dl1bz/NepControl50W/HF50W-auto-www.60dbm.com.pdf

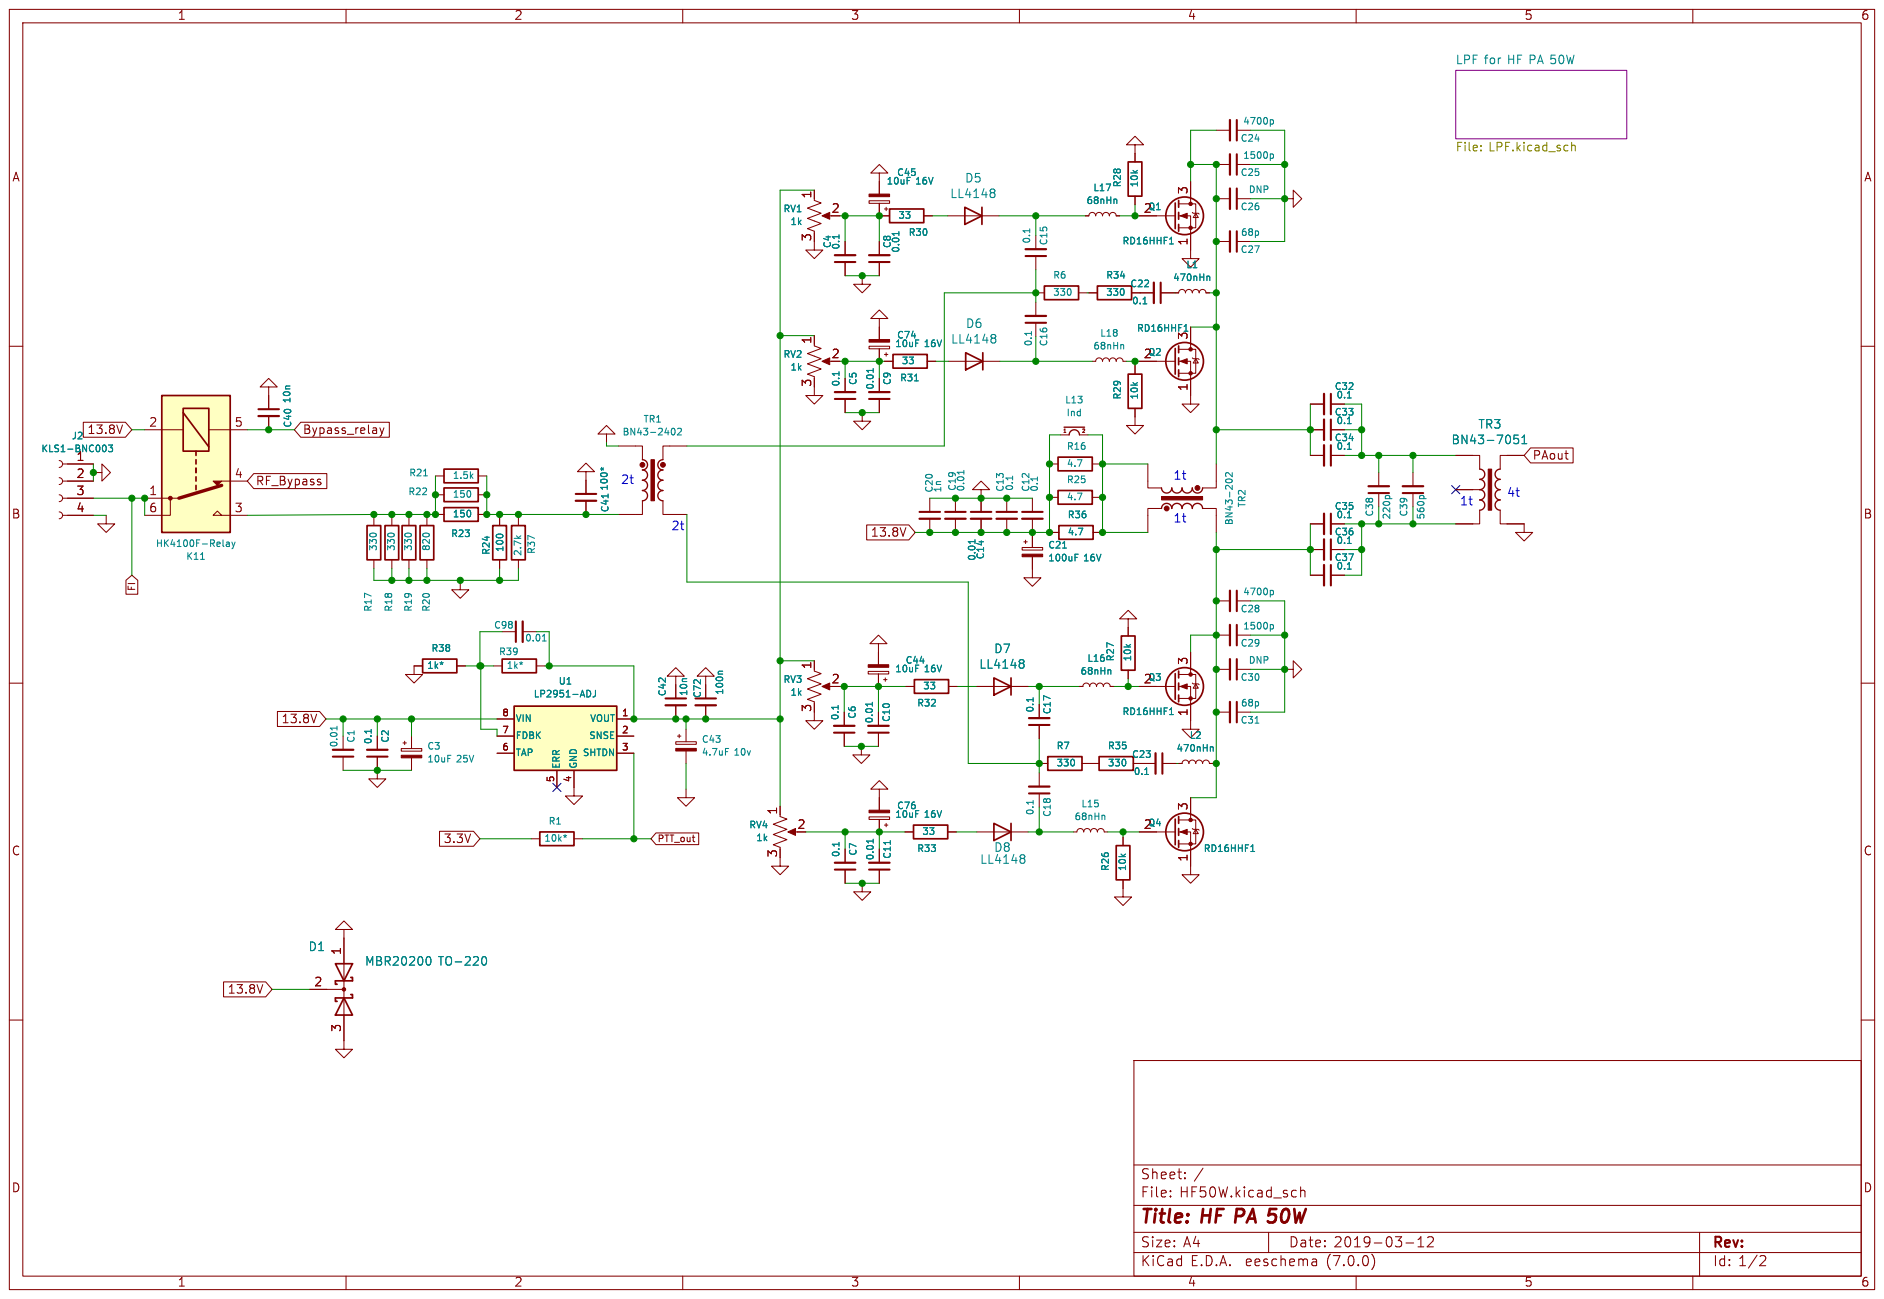
[picture p1: page 1]

File: HF50W.kicad_sch Sheet: /
Id: 1/2 Title: HF PA 50W

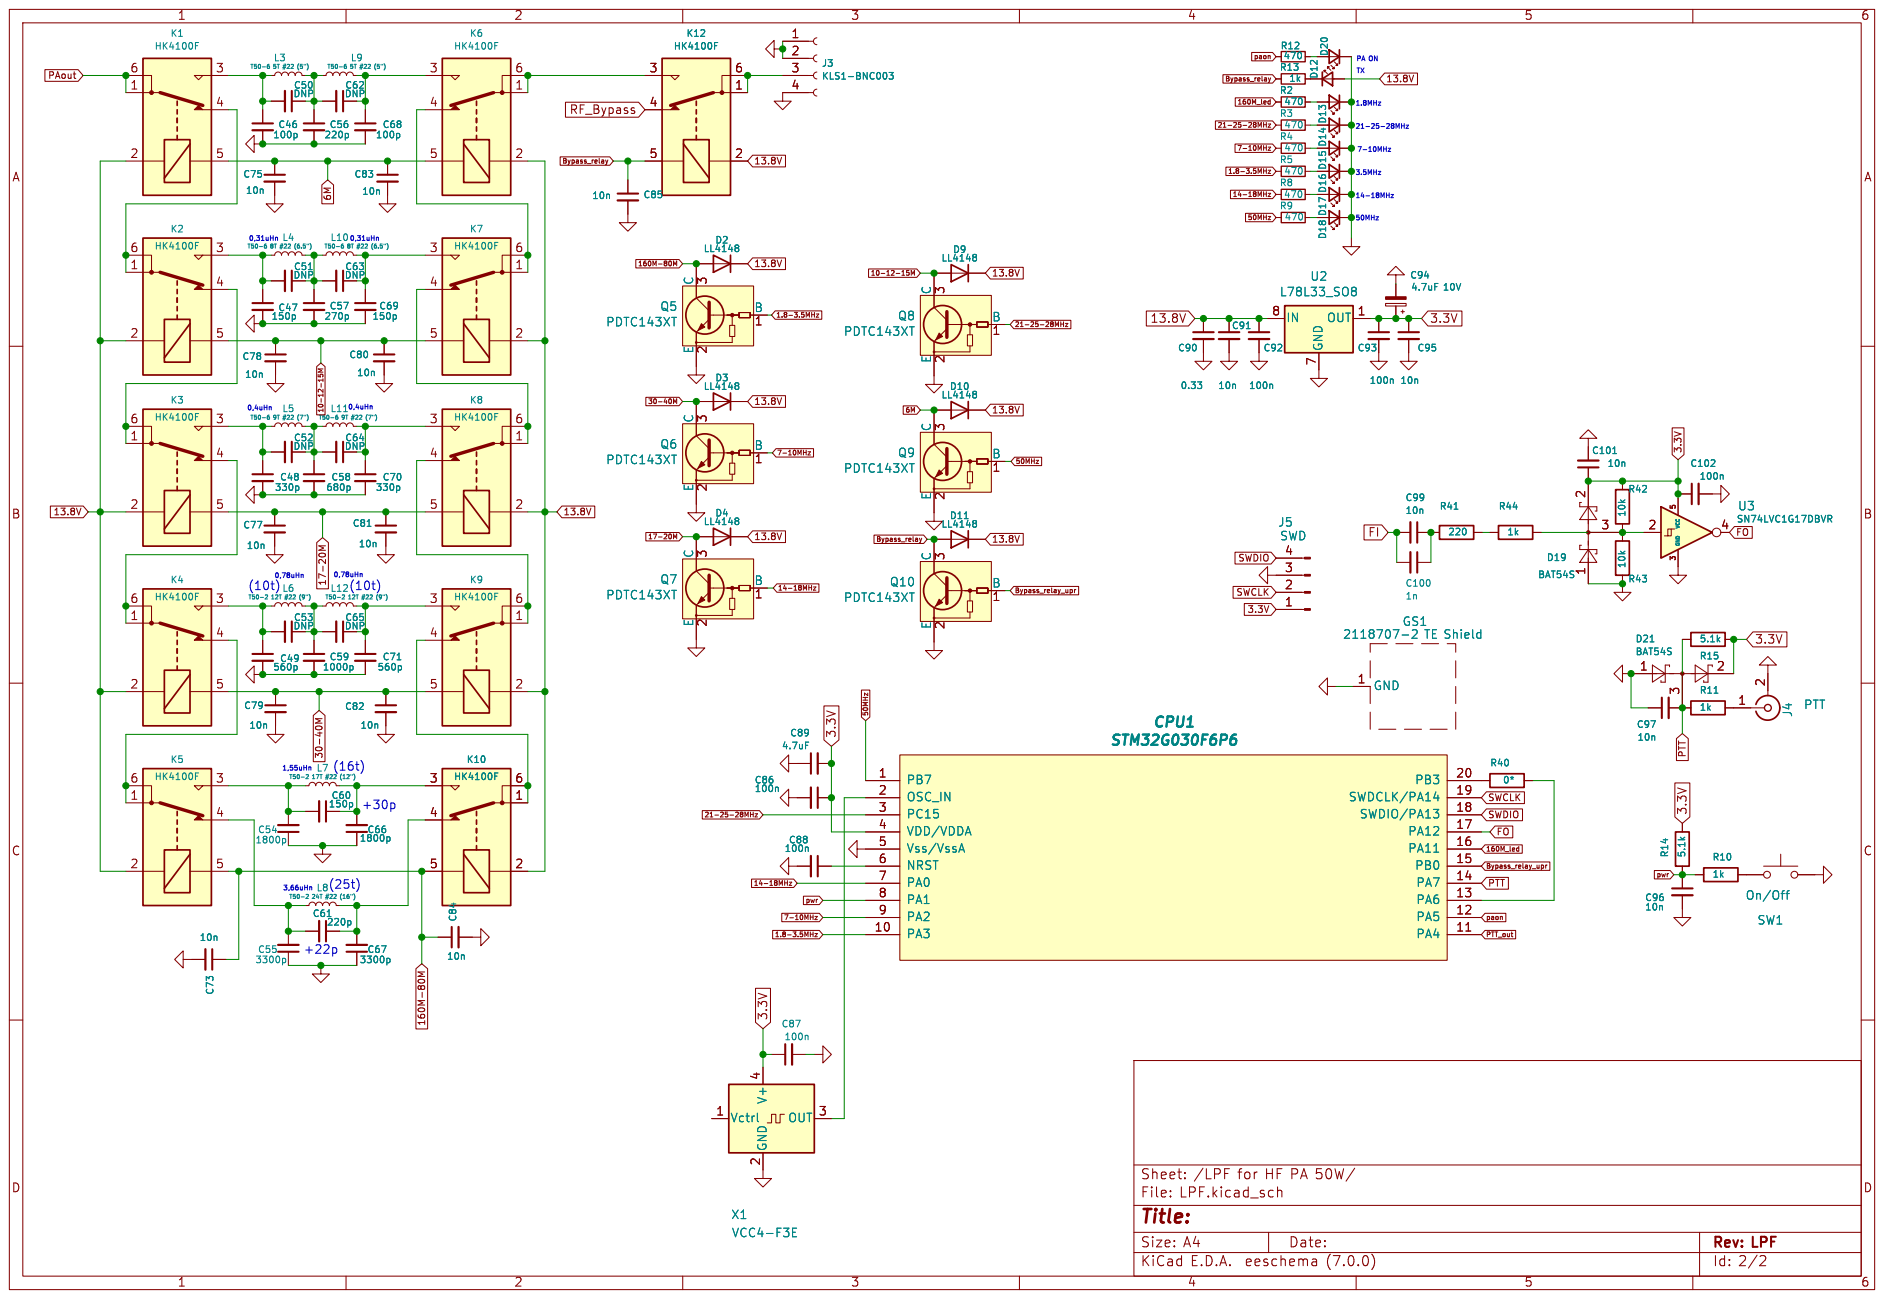
[picture p2: page 2]
