dl1bz/NepControl50W/Neptune_50W_ESP32control.pdf

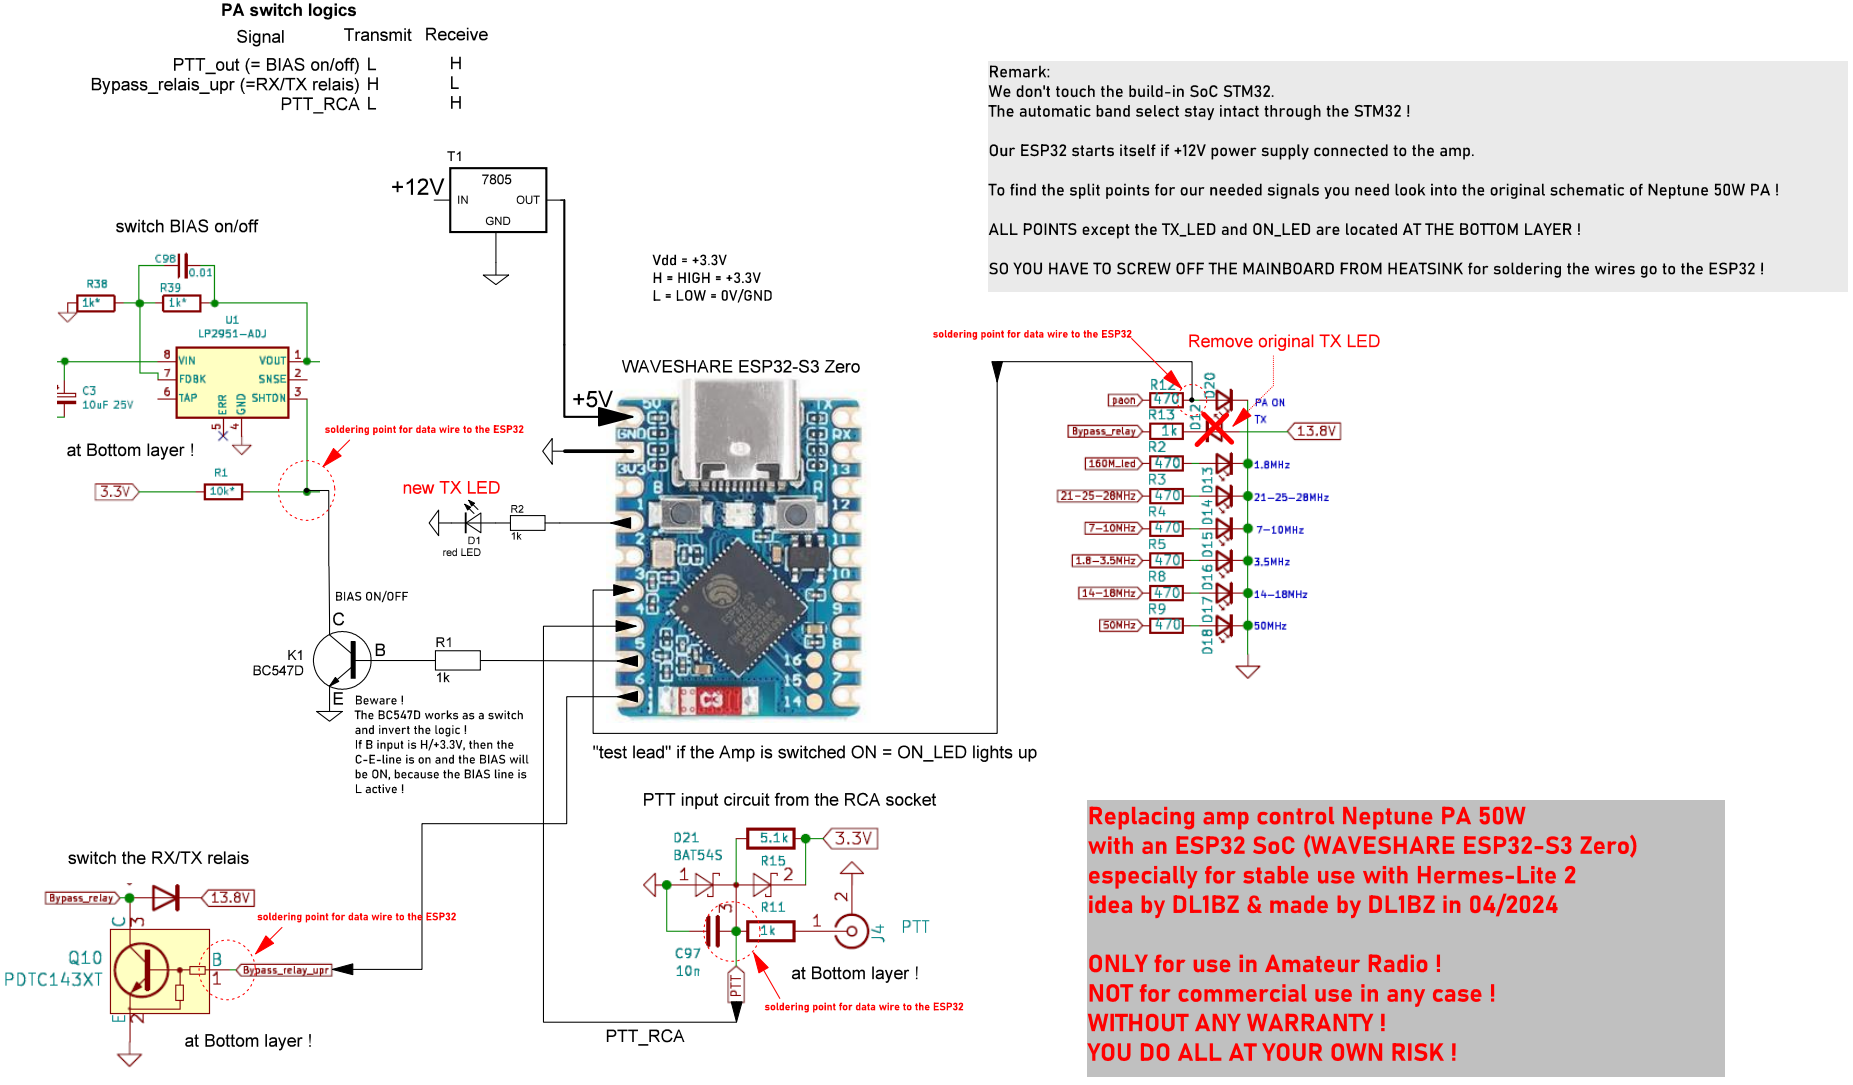
[picture p3: page 1]
