dl1bz/NepControl50W/NepControl50W/config.h

//----------------------------------------------------------------------------------------------
//    global Config file
//----------------------------------------------------------------------------------------------

//----------------------------------------------------------------------------------------------
#define VERSION "Neptune PA50 Control replacement V1.0 by DL1BZ"
#define DEBUG
//----------------------------------------------------------------------------------------------

//----------------------------------------------------------------------------------------------
// ESP32-S3 mini PIN definition
const int txLedPIN = 1;    // set TX LED
const int pttPIN = 4;      // get PTT input line for reading PTT at RCA socket
const int pwrPIN = 3;      // get the Power ON LED
const int txPIN = 6;       // set the RX/TX relais
const int biasPIN = 5;     // set the base of a BC547C transisitor for bias on/off
//----------------------------------------------------------------------------------------------

//----------------------------------------------------------------------------------------------
// global vars (start with G_)
boolean G_LEDState;
const int G_PTTDelay = 40;  // delay in ms for bias on 
//----------------------------------------------------------------------------------------------

//----------------------------------------------------------------------------------------------
// Timer variables
unsigned long lastTime = 0;
unsigned long pLastTime = 0;
unsigned long timerDelay = 500; // in ms, 1000 = 1s
//----------------------------------------------------------------------------------------------
